haxeko/matter-temperature-sensor-EFR32MG24/hardware/bom.csv

Ref | Qty | Value / function | Package | MPN | Manufacturer | LCSC | LCSC verified 2026-11-07 | JLC type | Approx USD @100 | Variant | Notes
U1 | 1 | SoC Matter/Thread/BLE 1536 kB/256 kB +10 dBm Secure Vault High | QFN40 5x5 | EFR32MG24B010F1536IM40-B | Silicon Labs | C6033375 | yes (49 pcs) | Extended | 9.66 | A | Alt: EFR32MG24B210F1536IM48-B (QFN48 6x6) C7271972; buy production qty from authorized distributor (DigiKey B210 ~5.68 @980)
U2 | 1 | Temp/RH sensor ±0.2 °C ±1.8 %RH | DFN-4 1.5x1.5 | SHT40-AD1B-R3 | Sensirion | C2848306 | yes | Extended | 1.22 | A/B | Alt: SHT45-AD1B C5221601 (±0.1 °C); SHT40-AD1F C7461846 (membrane IP68). Do not solder centre pad
Y1 | 1 | Crystal 39.000 MHz CL 10 pF ESR <=60 ohm | 2016 | TZ3541C | TST | C5360883 | yes | Extended | 0.24 | A | No external load caps (MG24 CTUNE); alt ECS-390-CDX-1932 C5441444; verify pins 1/3 = crystal 2/4 = GND
Y2 | 1 | Crystal 32.768 kHz CL 9 pF | 2012 | FC-12M 32.768kHz 9pF | Epson | C96341 | yes | Extended | 0.25 | A/B | CL must be <=12 pF (internal caps); alt NDK NX1610SA 6 pF C1987116 / Epson FC-135 7 pF C48615
L1 | 1 | DCDC inductor 2.2 uH DCR ~0.1 ohm | 1008 (2520) | DFE2HCAH2R2MJ0L | Murata | C2043106 | yes | Extended | 0.20 | A | Datasheet reference part; alt DFE201610E-2R2M=P2 C337891 (0806/2016)
ANT1 | 1 | 2.4 GHz meandered inverted-F antenna drawn in PCB copper (TI AN043 / CC2511 dongle) | PCB copper 15.2x5.7 mm | - | - | - | - | - | 0 | A | No part: footprint tsensor:PCB_Antenna_IFA_2G4_TI-AN043 (F.Cu graphics + net tie 1-2); ground reference In1.Cu; tune pi network (C14 R1 C15) and if needed trim open end L1 with VNA in final enclosure with battery
Q1 | 1 | P-MOSFET reverse-battery -20 V Rds 62 mohm @-1.8 V | SOT-23 | DMP2035U-7 | Diodes | C110499 | yes | Extended | 0.13 | A/B | G=1 S=2 D=3 (verify); alt Si2301CDS C10487 (Basic; spec only at -2.5 V); avoid AO3401A (Vgs(th) up to -1.3 V)
C1-C2 | 2 | Reservoir 100 uF 6.3 V X5R (~40 uF each at 3 V) | 1206 | CL31A107MQHNNNE | Samsung | C15008 | yes | Basic | 0.11 | A/B | Measure leakage (T1.14); alt Murata GRM31CR60J107ME39L C77085
C3-C4 | 2 | DCDC CIN (VREGVDD) and CDCDC (VDCDC) 4.7 uF 6.3 V X7R | 0603 | TCC0603X7R475K6R3CT | TCC | C5360855 | yes (13k pcs) | Extended | 0.02 | A | Datasheet: CDCDC 4.7 uF X7R (max 10 uF); CIN >= CDCDC
C5-C9 C16 | 6 | Decoupling 100 nF X7R (AVDD IOVDD DVDD RFVDD PAVDD SHT40) | 0402 | CL05B104KO5NNNC | Samsung | C1525 | yes | Basic | 0.003 | A | Final values per Silicon Labs reference schematic
C10 | 1 | DECOUPLE 1 uF | 0402 | CL05A105KA5NQNC | Samsung | C52923 | yes | Basic | 0.006 | A | Datasheet: 1.0 uF (max 2.75 uF)
L2 | 1 | RF match 2.5 nH | 0201 | LQP03HQ2N5B02D | Murata | C237441 | yes | Extended | 0.04 | A | Values from BRD4186C manual (search excerpt) - VERIFY for QFN40 via AN930.2
L3 | 1 | RF match 1.7 nH | 0201 | LQP03HQ1N7B02D | Murata | C2041495 | yes (4 pcs!) | Extended | 0.04 | A | Low stock - order from distributor
C11 | 1 | RF match 2.3 pF C0G | 0201 | GRM0335C1H2R3WA01D | Murata | C710810 | yes | Extended | 0.008 | A | VERIFY
C12 | 1 | RF match 1.6 pF C0G | 0201 | GRM0335C1H1R6WA01D | Murata | C1864525 | yes | Extended | 0.009 | A | VERIFY
C13 | 1 | DC block 18 pF C0G | 0201 | GRM0335C1H180JA01D | Murata | C85892 | yes | Extended | 0.004 | A
C14-C15 | 2 | Antenna pi-network shunt (DNP) | 0402 | - | - | - | - | - | 0 | A | Do not populate; tune with VNA in final enclosure with battery
R1 | 1 | Antenna pi-network series 0 ohm | 0402 | 0402WGF0000TCE | UNI-ROYAL | C17168 | yes | Basic | 0.001 | A
R2-R3 | 2 | I2C pull-up 10 k | 0402 | 0402WGF1002TCE | UNI-ROYAL | C25744 | yes | Basic | 0.003 | A/B
R4 | 1 | LED series 680 ohm (~1.5 mA @3 V) | 0402 | 0402WGF6800TCE | UNI-ROYAL | C25130 | yes | Extended | 0.001 | A/B
R5 | 1 | Q1 gate to GND 10 k | 0402 | 0402WGF1002TCE | UNI-ROYAL | C25744 | yes | Basic | 0.003 | A/B
D1 | 1 | LED red AlInGaP (specified at 2 mA) | 0603 | APTD1608LSURCK | Kingbright | C5342734 | yes | Extended | 0.10 | A/B | Red/amber keeps working at 2.2 V; alt KT-0603R C2286 (Basic)
SW1 | 1 | Tactile switch SMD 3.9x3.0x2.0 mm 2-pin 160 gf top-actuated | SMD 3.9x3.0 2-pad | TS-1088-AR02016 | XUNPU | C720477 | yes (933k pcs; checked 2026-11-10) | Basic | 0.04 | A/B | Custom footprint tsensor:SW_SPST_XUNPU_TS-1088_3.9x3mm (pads 1.05x2.0 mm at +/-2.225 mm per maker drawing)
BT1 | 1 | CR2450 SMD clip (+); negative contact = 9 mm ENIG pad on PCB bottom | SMD 29.1x15.4 | MY-2450-03 | MYOUNG | C2988622 | yes (5338 pcs) | Extended | 0.43 | A/B | Bottom side: 2-sided PCBA or hand solder; pad span 29.90 mm outer-to-outer per drawing
J1 | 1 | Debug Tag-Connect TC2030-NL footprint (no part) | pads + 3 NPTH | - | Tag-Connect | - | - | - | 0 | A/B | Pads: 1 VCC 2 SWDIO 3 nRESET 4 SWCLK 5 GND 6 SWO; cable TC2030-CTX-NL
TP1-TP6 | 6 | Test pads VBAT GND VCOM_TX VCOM_RX PTI_DATA PTI_FRAME | pad D1.0 | - | - | - | - | - | 0 | A/B | PTI/VCOM only needed on prototype boards
U1B | 1 | ALTERNATIVE variant B: certified SiP module +10 dBm | SiP 7x7 | MGM240SD22VNA2 (Vault High) / MGM240SA22VNA2 | Silicon Labs | C6300805 / C6300803 | yes (SD22 0 pcs; SA22 4 pcs) | Extended | 15.45 | B | Replaces U1 Y1 L1 ANT1 L2 L3 C11-C15 R1; antenna = loop drawn in host PCB copper per datasheet; best on 55x30 mm board
