haxeko/matter-temperature-sensor-EFR32MG24/hardware/kicad/tsensor.kicad_pcb

## KiCad design hardware/kicad/tsensor.kicad_pcb (2026-11-10)

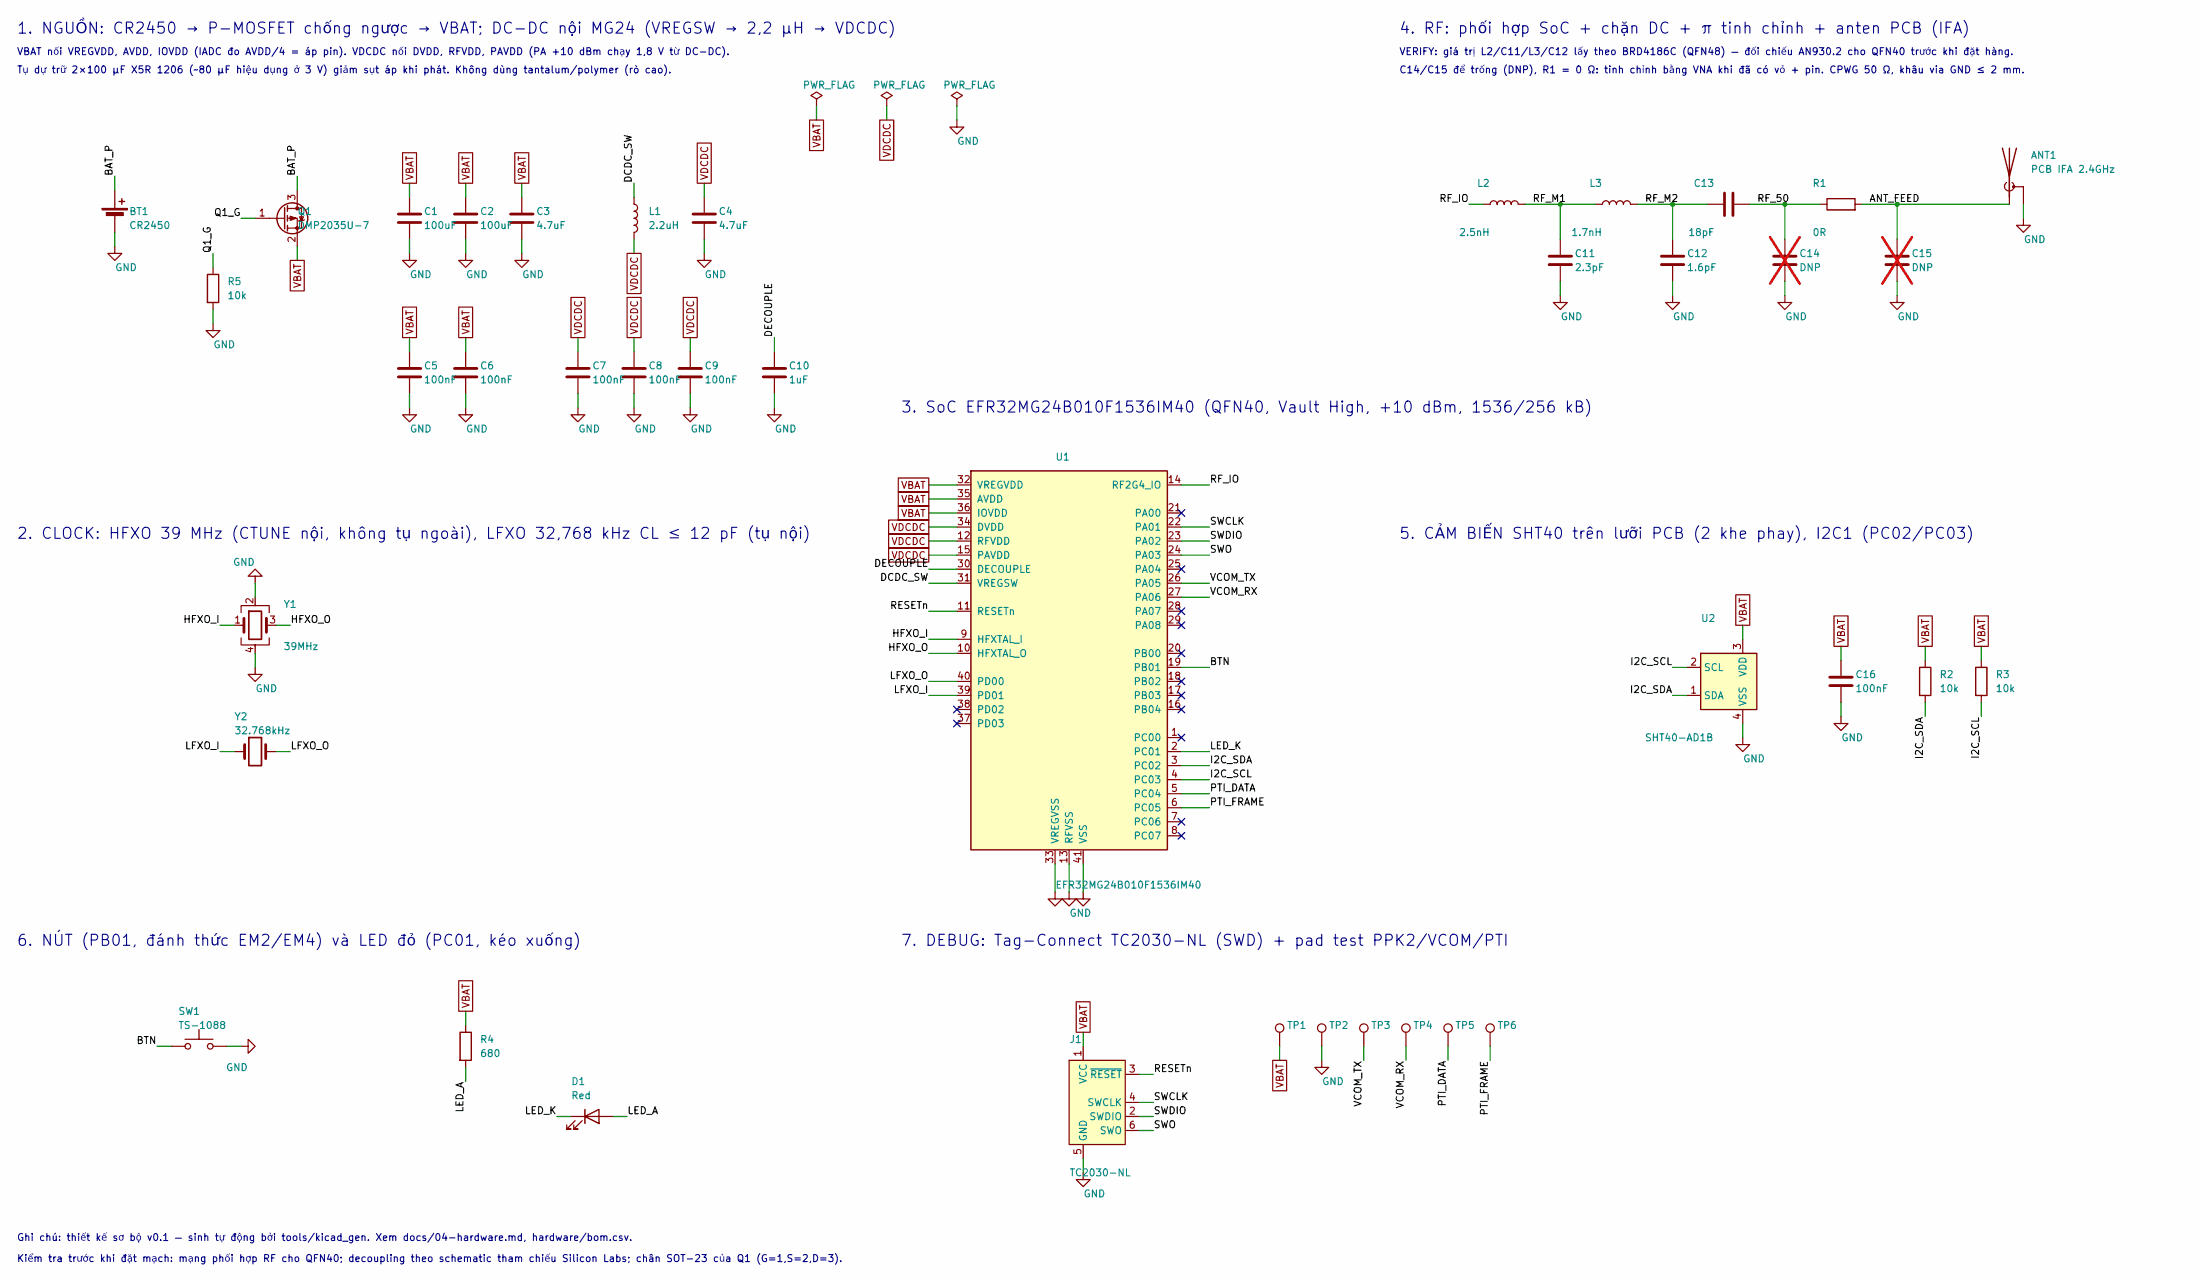
[picture p1: schematic tsensor.kicad_sch, Matter T/RH sensor - EFR32MG24 + CR2450]

Parts:
ANT1: PCB IFA 2.4GHz; PCB_Antenna_IFA_2G4_TI-AN043
BT1: CR2450; BatteryClip_MYOUNG_MY-2450-03_CR2450; MPN MY-2450-03; LCSC C2988622
C1, C2: 100uF; C_1206_3216Metric; MPN CL31A107MQHNNNE; LCSC C15008
C3, C4: 4.7uF; C_0603_1608Metric; MPN TCC0603X7R475K6R3CT; LCSC C5360855
C5, C6, C7, C8, C9, C16: 100nF; C_0402_1005Metric; MPN CL05B104KO5NNNC; LCSC C1525
C10: 1uF; C_0402_1005Metric; MPN CL05A105KA5NQNC; LCSC C52923
C11: 2.3pF; C_0201_0603Metric; MPN GRM0335C1H2R3WA01D; LCSC C710810
C12: 1.6pF; C_0201_0603Metric; MPN GRM0335C1H1R6WA01D; LCSC C1864525
C13: 18pF; C_0201_0603Metric; MPN GRM0335C1H180JA01D; LCSC C85892
C14, C15: DNP; C_0402_1005Metric; not fitted
D1: Red; LED_0603_1608Metric; MPN APTD1608LSURCK; LCSC C5342734
J1: TC2030-NL; Tag-Connect_TC2030-IDC-NL_2x03_P1.27mm_Vertical
L1: 2.2uH; L_1008_2520Metric; MPN DFE2HCAH2R2MJ0L; LCSC C2043106
L2: 2.5nH; L_0201_0603Metric; MPN LQP03HQ2N5B02D; LCSC C237441
L3: 1.7nH; L_0201_0603Metric; MPN LQP03HQ1N7B02D; LCSC C2041495
Q1: DMP2035U-7; SOT-23; MPN DMP2035U-7; LCSC C110499
R1: 0R; R_0402_1005Metric; MPN 0402WGF0000TCE; LCSC C17168
R2, R3, R5: 10k; R_0402_1005Metric; MPN 0402WGF1002TCE; LCSC C25744
R4: 680; R_0402_1005Metric; MPN 0402WGF6800TCE; LCSC C25130
SW1: TS-1088; SW_SPST_XUNPU_TS-1088_3.9x3mm; MPN TS-1088-AR02016; LCSC C720477
TP1: VBAT; TestPoint_Pad_D1.0mm
TP2: GND; TestPoint_Pad_D1.0mm
TP3: VCOM_TX; TestPoint_Pad_D1.0mm
TP4: VCOM_RX; TestPoint_Pad_D1.0mm
TP5: PTI_DATA; TestPoint_Pad_D1.0mm
TP6: PTI_FRAME; TestPoint_Pad_D1.0mm
U1: EFR32MG24B010F1536IM40; EFR32MG24_QFN40_5x5mm_P0.4mm_EP3.85x3.85mm; MPN EFR32MG24B010F1536IM40-B; LCSC C6033375
U2: SHT40-AD1B; Sensirion_DFN-4_1.5x1.5mm_P0.8mm_SHT4x_NoCentralPad; MPN SHT40-AD1B-R3; LCSC C2848306
Y1: 39MHz; Crystal_SMD_2016-4Pin_2.0x1.6mm; MPN TZ3541C; LCSC C5360883
Y2: 32.768kHz; Crystal_SMD_2012-2Pin_2.0x1.2mm; MPN FC-12M 32.768kHz 9pF; LCSC C96341

Connections:
/ANT_FEED: ANT1.1 (A), C15.1, R1.2
/BAT_P: BT1.1 (+), Q1.3 (D)
/BTN: SW1.1, U1.19 (PB01)
/DCDC_SW: L1.1, U1.31 (VREGSW)
/DECOUPLE: C10.1, U1.30 (DECOUPLE)
/HFXO_I: U1.9 (HFXTAL_I), Y1.1
/HFXO_O: U1.10 (HFXTAL_O), Y1.3
/I2C_SCL: R3.2, U1.4 (PC03), U2.2 (SCL)
/I2C_SDA: R2.2, U1.3 (PC02), U2.1 (SDA)
/LED_A: D1.2 (A), R4.2
/LED_K: D1.1 (K), U1.2 (PC01)
/LFXO_I: U1.39 (PD01), Y2.1
/LFXO_O: U1.40 (PD00), Y2.2
/PTI_DATA: TP5.1, U1.5 (PC04)
/PTI_FRAME: TP6.1, U1.6 (PC05)
/Q1_G: Q1.1 (G), R5.1
/RESETn: J1.3 (~RESET), U1.11 (RESETn)
/RF_50: C13.2, C14.1, R1.1
/RF_IO: L2.1, U1.14 (RF2G4_IO)
/RF_M1: C11.1, L2.2, L3.1
/RF_M2: C12.1, C13.1, L3.2
/SWCLK: J1.4 (SWCLK), U1.22 (PA01)
/SWDIO: J1.2 (SWDIO), U1.23 (PA02)
/SWO: J1.6 (SWO), U1.24 (PA03)
/VCOM_RX: TP4.1, U1.27 (PA06)
/VCOM_TX: TP3.1, U1.26 (PA05)
GND: ANT1.2 (Shield), BT1.2 (-), C1.2, C2.2, C3.2, C4.2, C5.2, C6.2, C7.2, C8.2, C9.2, C10.2, C11.2, C12.2, C14.2, C15.2, C16.2, J1.5 (GND), R5.2, SW1.2, TP2.1, U1.13 (RFVSS), U1.33 (VREGVSS), U1.41 (VSS), U2.4 (VSS), Y1.2, Y1.4
VBAT: C1.1, C2.1, C3.1, C5.1, C6.1, C16.1, J1.1 (VCC), Q1.2 (S), R2.1, R3.1, R4.1, TP1.1, U1.32 (VREGVDD), U1.35 (AVDD), U1.36 (IOVDD), U2.3 (VDD)
VDCDC: C4.1, C7.1, C8.1, C9.1, L1.2, U1.12 (RFVDD), U1.15 (PAVDD), U1.34 (DVDD)

Notes on the sheet:
1. NGUỒN: CR2450 → P-MOSFET chống ngược → VBAT; DC-DC nội MG24 (VREGSW → 2,2 µH → VDCDC)
VBAT nối VREGVDD, AVDD, IOVDD (IADC đo AVDD/4 = áp pin). VDCDC nối DVDD, RFVDD, PAVDD (PA +10 dBm chạy 1,8 V từ DC-DC).
Tụ dự trữ 2×100 µF X5R 1206 (~80 µF hiệu dụng ở 3 V) giảm sụt áp khi phát. Không dùng tantalum/polymer (rò cao).
2. CLOCK: HFXO 39 MHz (CTUNE nội, không tụ ngoài), LFXO 32,768 kHz CL ≤ 12 pF (tụ nội)
3. SoC EFR32MG24B010F1536IM40 (QFN40, Vault High, +10 dBm, 1536/256 kB)
4. RF: phối hợp SoC + chặn DC + π tinh chỉnh + anten PCB (IFA)
VERIFY: giá trị L2/C11/L3/C12 lấy theo BRD4186C (QFN48) — đối chiếu AN930.2 cho QFN40 trước khi đặt hàng.
C14/C15 để trống (DNP), R1 = 0 Ω: tinh chỉnh bằng VNA khi đã có vỏ + pin. CPWG 50 Ω, khâu via GND ≤ 2 mm.
5. CẢM BIẾN SHT40 trên lưỡi PCB (2 khe phay), I2C1 (PC02/PC03)
6. NÚT (PB01, đánh thức EM2/EM4) và LED đỏ (PC01, kéo xuống)
7. DEBUG: Tag-Connect TC2030-NL (SWD) + pad test PPK2/VCOM/PTI
Ghi chú: thiết kế sơ bộ v0.1 — sinh tự động bởi tools/kicad_gen. Xem docs/04-hardware.md, hardware/bom.csv.
Kiểm tra trước khi đặt mạch: mạng phối hợp RF cho QFN40; decoupling theo schematic tham chiếu Silicon Labs; chân SOT-23 của Q1 (G=1,S=2,D=3).

Board: 4 copper layers, 40 parts (1 on the bottom side), 29 nets, no tracks yet.
