haxeko/matter-temperature-sensor-EFR32MG24/(commit log)

2026-11-07 Add design package for CR2450 Matter-over-Thread temp/RH sensor on EFR32MG24
    Design documents (Vietnamese), following the requested section order:
    - 01: requirements, chip-down MG24 vs MGM240S/MGM240P, requirement conflicts
    - 02: Matter 1.6 compliance: endpoints, Power Source for CR2450, ICD
    SIT/LIT/Check-In/UAT parameters, ecosystem LIT support, subscriptions,
    commissioning, DAC/PAI/PAA/CD, DIY vs commercial, OTA
    - 03: commercial benchmark (Eve Weather, Aqara W100/T1, Onvis, IKEA)
    - 04: sensor selection, CR2450 power/peak-current analysis, reverse
    protection, battery sensing, RF/antenna, crystals, layout, draft BOM
    - 05: firmware architecture, flows, button/LED, ICD policy, recovery
    -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
    [bom.csv]
2026-11-07 Add KiCad project: schematic, placed 4-layer PCB, custom libs, generator
    - hardware/kicad: KiCad 7 project (opens in KiCad >= 7)
    - tsensor.kicad_sch: full A3 schematic (power, MG24, clocks, RF match +
    pi tuning + chip antenna, SHT40, button/LED, TC2030 + test pads);
    netlist exported by kicad-cli matches design data (122 pins, 29 nets)
    - tsensor.kicad_pcb: 35 mm round board with milled sensor tongue,
    4-layer 0.8 mm ENIG stack-up, all parts placed, nets assigned,
    GND/VBAT zones, antenna and tongue keep-outs, GND stitching vias;
    DRC clean except unrouted connections (routing not done yet)
    - lib: EFR32MG24B010F1536IM40 symbol (datasheet Table 6.3), QFN40
    footprint p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
    [bom.csv, bom_jlcpcb.csv, tsensor.kicad_pcb, tsensor.kicad_sch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]
2026-11-09 PCB: replace back silkscreen text with product marking
    Back side now reads "Matter temperature Sensor / Villa Nest / Made in
    Vietnam" (replaces "CR2450 (+)"), placed between the TC2030 holes and the
    battery clip. DRC unchanged: 0 errors, only unrouted items.
    Claude-Session: https://claude.ai/code/session_01TvrXHVy6556R8PtiLmxTtJ
    [tsensor.kicad_pcb]
2026-11-10 PCB: copper IFA antenna on top edge, SHT40 at bottom edge, TS-1088 button
    - Replace the Johanson chip antenna with a meandered inverted-F antenna drawn
    in F.Cu (dimensions copied from TI AN043). Ground reference is In1.Cu, the
    ground leg goes to a via, and the feed leg sits in an F.Cu no-pour notch.
    The antenna keepout now also blocks tracks.
    - Move the sensor tongue to 6 o'clock (SHT40 at the bottom edge) and re-place
    the RF chain, MCU, crystals, button, LED, test pads and TC2030.
    - SW1: XUNPU TS-1088-AR02016 (SMD 3.9x3.0 mm, 2 pins, LCSC C720477, Basic)
    with a custom footprint from the maker drawing.
    - Back silkscreen: "Temperature sensor / Design by Haxeko / Made in Vietnam"
    i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
    [bom.csv, bom_jlcpcb.csv, tsensor.kicad_pcb, tsensor.kicad_sch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]
